necroware/xt_ide/(commit log)

2021-04-01 Silk layer fixes.
    Now showing calues of bypass caps and resistors
    [XT-IDE-B.Mask.gbs, XT-IDE-Component.gtl, XT-IDE-Copper.gbl, XT-IDE-Eco1.User.gbr, XT-IDE-Edge.Cuts.gm1, XT-IDE-F.Mask.gts, XT-IDE-F.SilkS.gto, XT-IDE.drl]
2021-04-01 Global solder mask and plot settings fixes
    [XT-IDE.kicad_pcb]
