necroware/xt_ide/(notices)

Notices in the files:
XT-IDE.kicad_pcb:
XT-IDE rev 04 (c) 2017 The Glitch Works
